PiotrRaszkowski/extended-ceiling-presence-air-sensor/v2/docs/images/v2-template.png

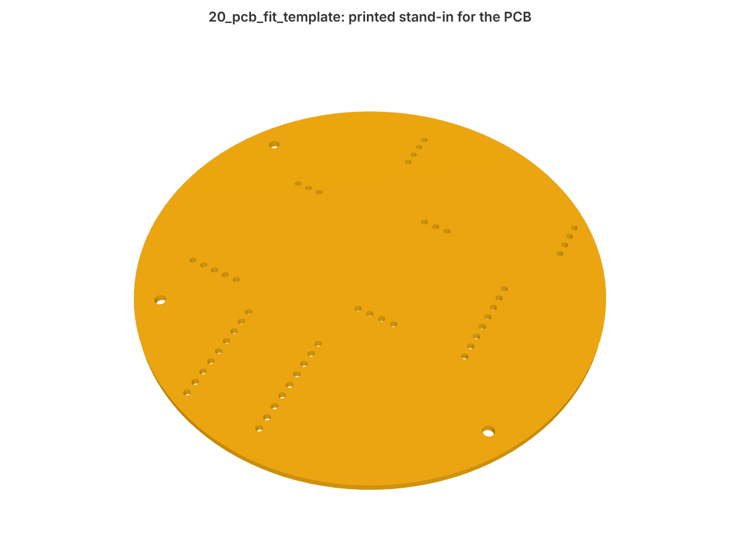
v2/docs/images/v2-template.png
