PiotrRaszkowski/extended-ceiling-presence-air-sensor/hardware/step/01_housing.step

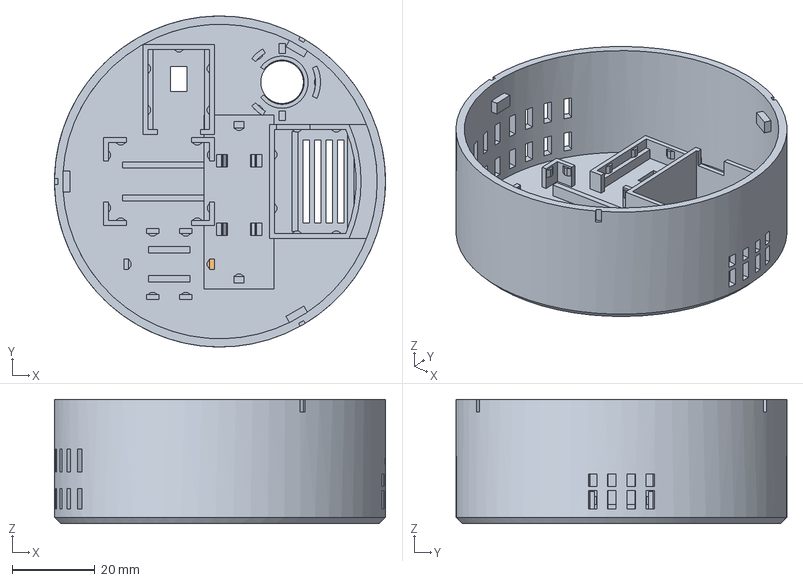
[picture p19: CAD file, 2026-10-31]
hardware/step/01_housing.step
80.0 x 80.0 x 30.0 mm
