PiotrRaszkowski/extended-ceiling-presence-air-sensor/v2/hardware/step/02_ceiling_base.step

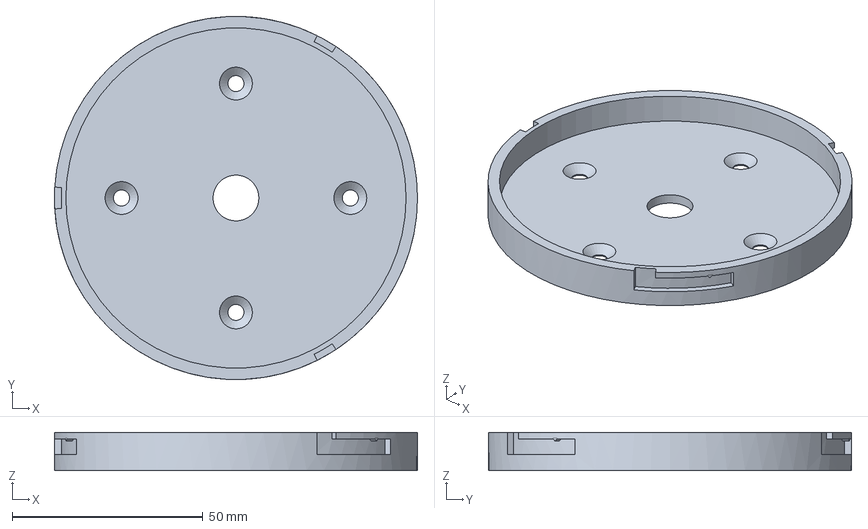
[picture p20: CAD file, 2026-10-30]
v2/hardware/step/02_ceiling_base.step
95.2 x 95.2 x 10.0 mm
