PiotrRaszkowski/extended-ceiling-presence-air-sensor/hardware/d100/step/11_seat_test_fit_d100.step

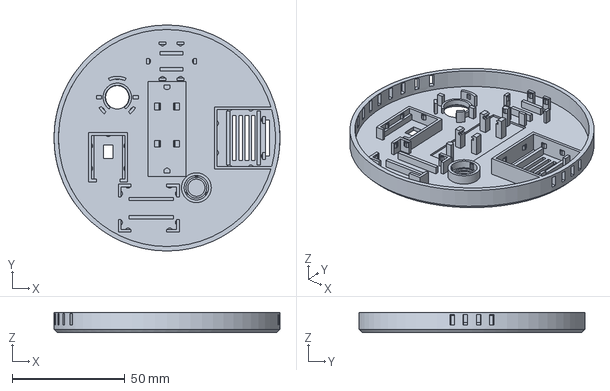
[picture p21: CAD file, 2026-11-01]
hardware/d100/step/11_seat_test_fit_d100.step
100.0 x 100.0 x 9.00 mm
