PiotrRaszkowski/extended-ceiling-presence-air-sensor/hardware/step/00_print_plate_all_parts.step

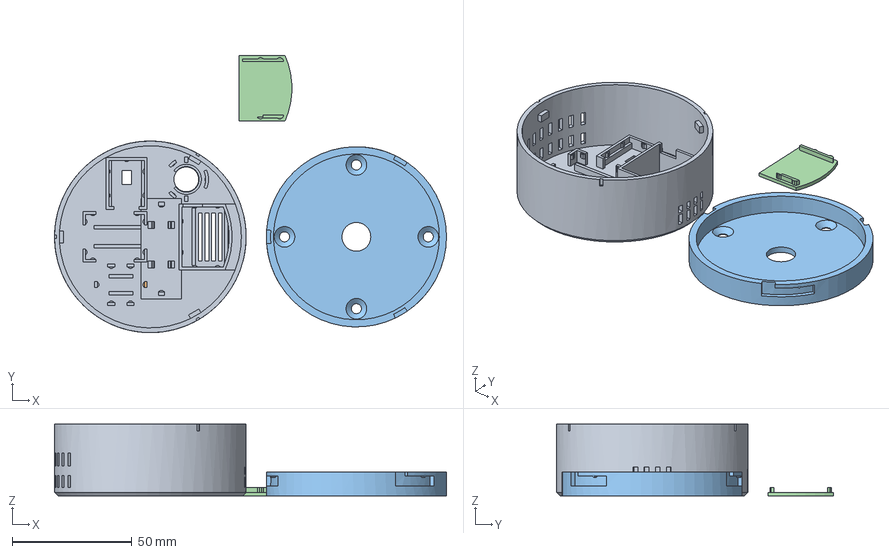
[picture p22: CAD file, 2026-10-31]
hardware/step/00_print_plate_all_parts.step
163.6 x 115.7 x 30.0 mm
