PiotrRaszkowski/extended-ceiling-presence-air-sensor/v2/hardware/step/20_pcb_fit_template.step

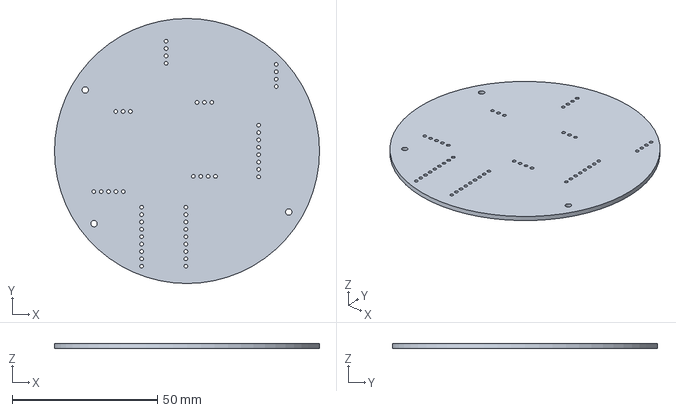
[picture p23: CAD file, 2026-10-30]
v2/hardware/step/20_pcb_fit_template.step
91.2 x 91.2 x 1.60 mm
