PiotrRaszkowski/extended-ceiling-presence-air-sensor/hardware/step/11_seat_test_fit.step

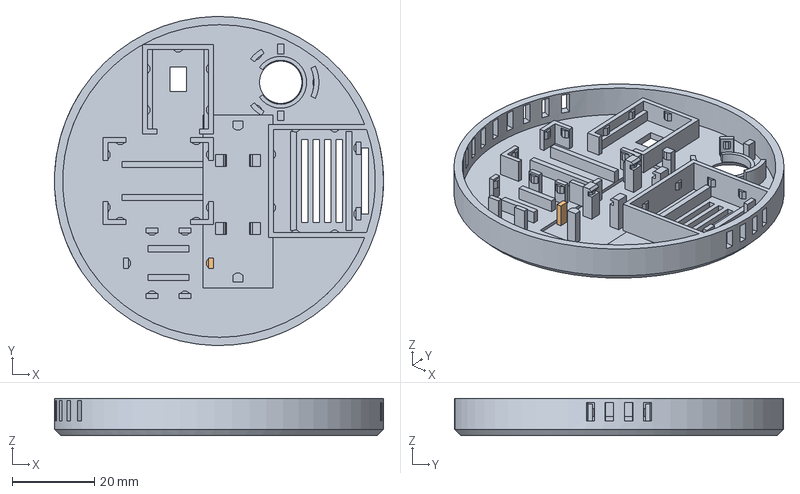
[picture p24: CAD file, 2026-10-31]
hardware/step/11_seat_test_fit.step
80.0 x 80.0 x 9.00 mm
