PiotrRaszkowski/extended-ceiling-presence-air-sensor/hardware/d100/step/00_print_plate_all_parts_d100.step

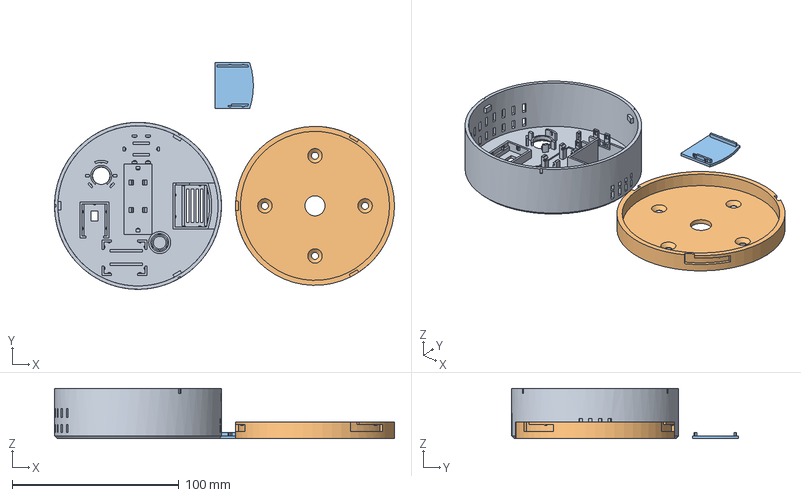
[picture p25: CAD file, 2026-11-01]
hardware/d100/step/00_print_plate_all_parts_d100.step
203.6 x 135.7 x 30.0 mm
