PiotrRaszkowski/extended-ceiling-presence-air-sensor/hardware/step/13_radar_seat_test.step

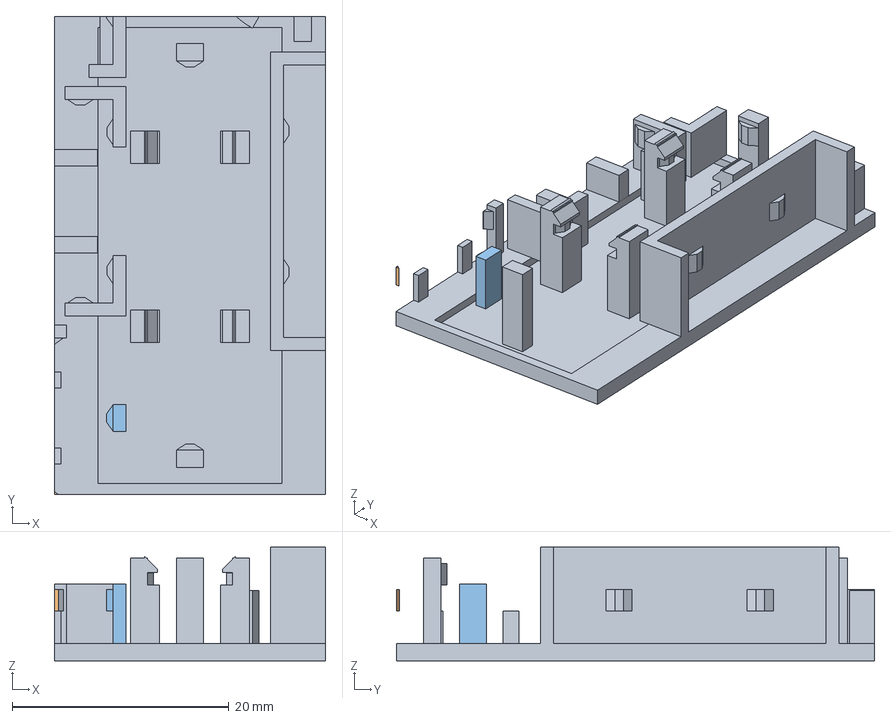
[picture p26: CAD file, 2026-10-31]
hardware/step/13_radar_seat_test.step
25.0 x 44.1 x 10.5 mm
