PiotrRaszkowski/extended-ceiling-presence-air-sensor/hardware/step/03_chamber_lid.step

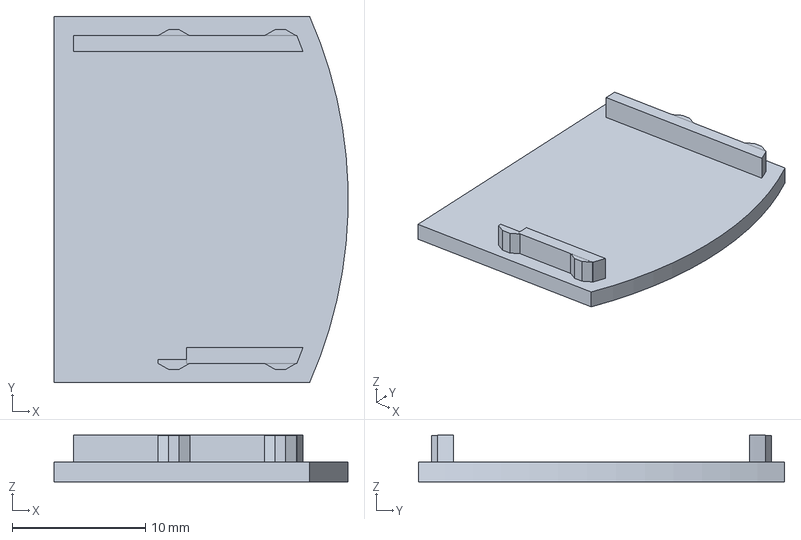
[picture p27: CAD file, 2026-10-31]
hardware/step/03_chamber_lid.step
22.1 x 27.5 x 3.50 mm
