PiotrRaszkowski/extended-ceiling-presence-air-sensor/hardware/d100/step/01_housing_d100.step

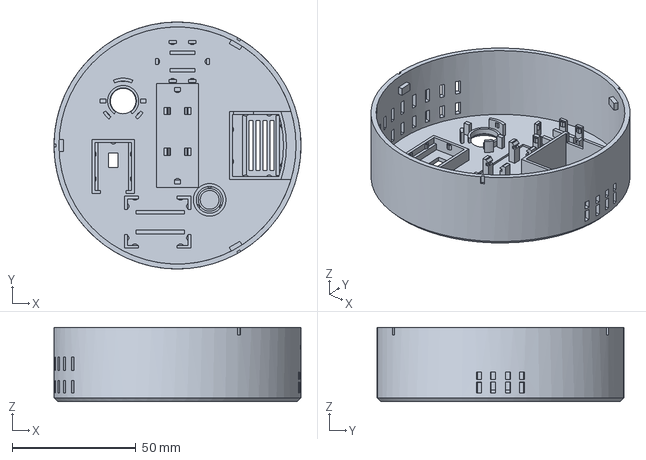
[picture p28: CAD file, 2026-11-01]
hardware/d100/step/01_housing_d100.step
100.0 x 100.0 x 30.0 mm
