PiotrRaszkowski/extended-ceiling-presence-air-sensor/hardware/step/12_radar_window_samples.step

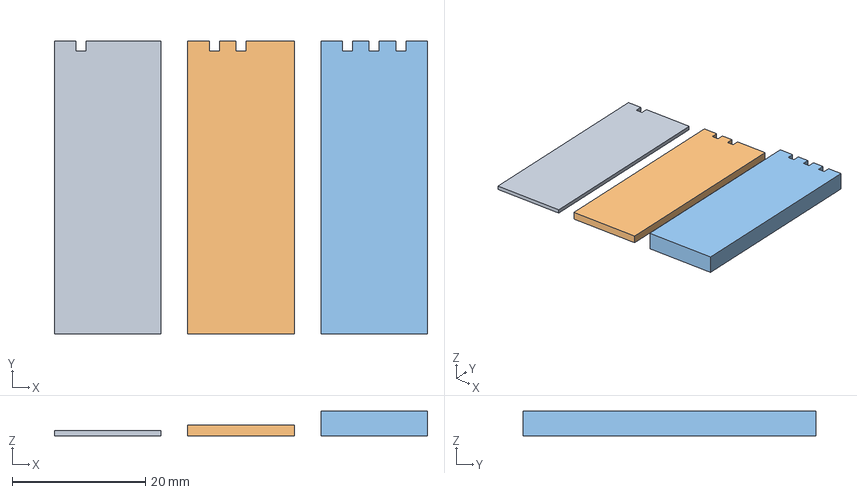
[picture p29: CAD file, 2026-10-29]
hardware/step/12_radar_window_samples.step
56.0 x 44.0 x 3.70 mm
