PiotrRaszkowski/extended-ceiling-presence-air-sensor/hardware/d100/step/13_radar_seat_test_d100.step

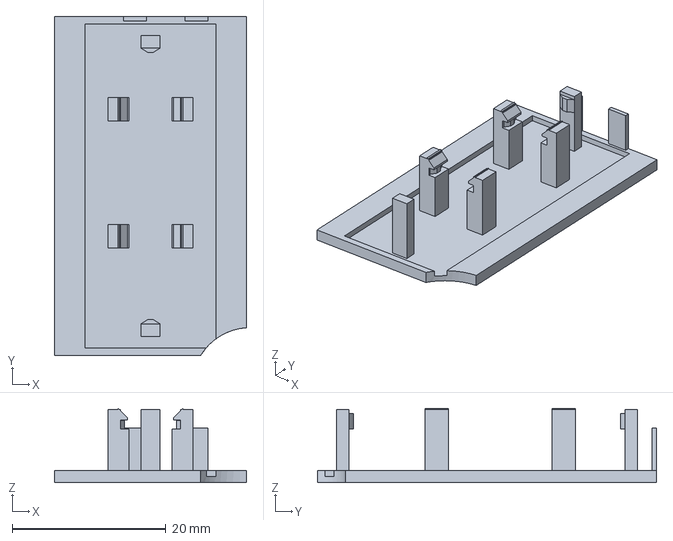
[picture p30: CAD file, 2026-10-31]
hardware/d100/step/13_radar_seat_test_d100.step
25.0 x 44.1 x 9.65 mm
