PiotrRaszkowski/extended-ceiling-presence-air-sensor/hardware/step/10_press_fit_calibration.step

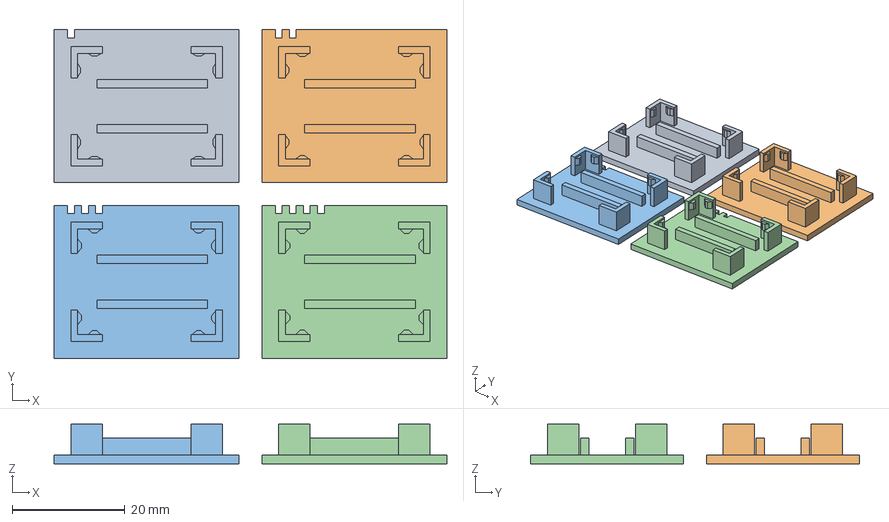
[picture p31: CAD file, 2026-10-29]
hardware/step/10_press_fit_calibration.step
69.8 x 58.4 x 7.10 mm
