PiotrRaszkowski/extended-ceiling-presence-air-sensor/hardware/d100/step/13_radar_seat_test_d100_ld2412.step

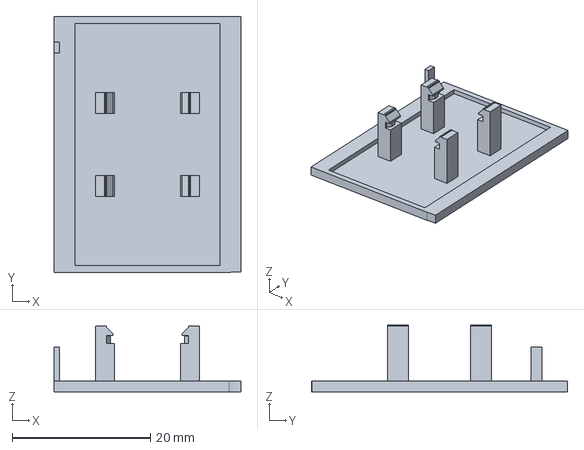
[picture p32: CAD file, 2026-10-31]
hardware/d100/step/13_radar_seat_test_d100_ld2412.step
27.0 x 37.0 x 9.65 mm
