PiotrRaszkowski/extended-ceiling-presence-air-sensor/hardware/step/02_ceiling_base.step

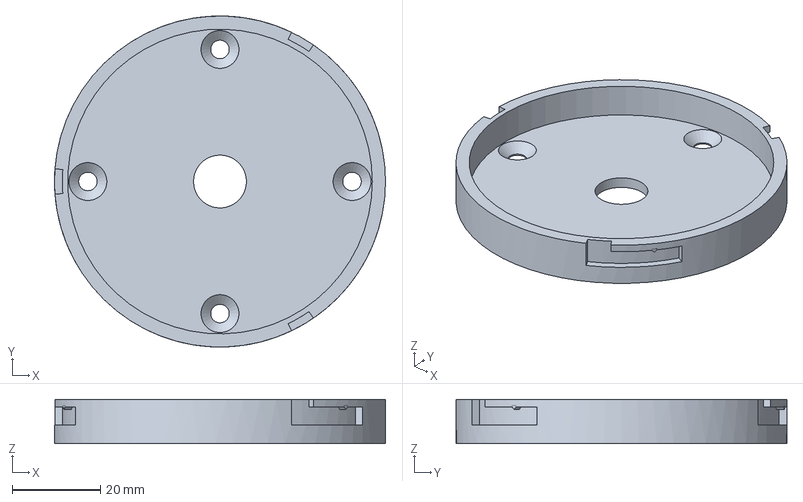
[picture p33: CAD file, 2026-10-29]
hardware/step/02_ceiling_base.step
75.2 x 75.2 x 10.0 mm
