PiotrRaszkowski/extended-ceiling-presence-air-sensor/hardware/d100/step/03_chamber_lid_d100.step

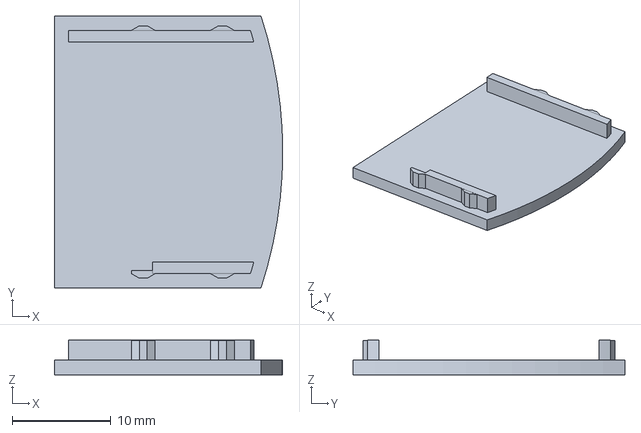
[picture p34: CAD file, 2026-10-31]
hardware/d100/step/03_chamber_lid_d100.step
23.1 x 27.5 x 3.50 mm
