PiotrRaszkowski/extended-ceiling-presence-air-sensor/(list of files, cad)

Other CAD files:
hardware/d100/step/11_seat_test_fit_d100_ld2412.step
v2/hardware/step/01_housing_v2.step
hardware/d100/step/00_print_plate_all_parts_d100_ld2412.step
hardware/d100/step/02_ceiling_base_d100.step
hardware/d100/stl/00_print_plate_all_parts_d100.stl
hardware/d100/stl/00_print_plate_all_parts_d100_ld2412.stl
hardware/d100/stl/01_housing_d100.stl
hardware/d100/stl/01_housing_d100_ld2412.stl
hardware/d100/stl/02_ceiling_base_d100.stl
hardware/d100/stl/03_chamber_lid_d100.stl
hardware/d100/stl/11_seat_test_fit_d100.stl
hardware/d100/stl/11_seat_test_fit_d100_ld2412.stl
hardware/d100/stl/13_radar_seat_test_d100.stl
hardware/d100/stl/13_radar_seat_test_d100_ld2412.stl
hardware/stl/00_print_plate_all_parts.stl
hardware/stl/01_housing.stl
hardware/stl/02_ceiling_base.stl
hardware/stl/03_chamber_lid.stl
hardware/stl/10_press_fit_calibration.stl
hardware/stl/11_seat_test_fit.stl
hardware/stl/12_radar_window_samples.stl
hardware/stl/13_radar_seat_test.stl
v2/hardware/stl/01_housing_v2.stl
v2/hardware/stl/02_ceiling_base.stl
v2/hardware/stl/20_pcb_fit_template.stl
