PiotrRaszkowski/extended-ceiling-presence-air-sensor/docs/assembly.md

# Assembly

What goes where

## 0. Bench test first

Before anything goes into the housing:

1. Flash the firmware over USB (see [firmware](firmware.md)).
2. Solder 8-10 cm wires to every module and wire everything up on the desk as in [wiring](wiring.md).
3. Power it from 12 V and check in Home Assistant that every sensor reports: occupancy, radar distances, illuminance, temperature, humidity. eCO2, TVOC and AQI stay empty for the first few minutes, and on the very first power-on for about an hour while the ENS160 runs its initial start-up.

Once the housing is closed the USB-C port is out of reach, so this is the moment to fix wiring mistakes.

## 1. Modules into their seats

A real Ø80 print (v12, before the hub seat was added) with all modules in place (ceiling side; in the first photo the ENS160 chamber is at the bottom, so the picture is turned 90° compared with the render below):

| | |
|---|---|
| All modules seated in a printed Ø80 housing, top view | The same housing from an angle |

Seen from the ceiling side (the open side of the housing), the layout is: ENS160 chamber along the right wall, the long radar board running top to bottom just left of the chamber, ESP32-S3-Zero and the S09 converter on the left next to the side vents, BH1750 top left, PIR top right. The Dupont hub stands upright against the outside of the chamber's inner wall, above the radar.

Each board sits on ledges and is gripped by small crush ribs. Push it in straight with a thumb; it should stay put without glue. If one ever works loose, a dot of hot glue on the board end fixes it.

| # | Module | How it goes in |
|---|---|---|
| 1 | LD2410B radar | Antenna side down, towards the face (the side with the gold antenna patches). Push it down between the six posts until it clicks under the four snap lips and sits on the small tabs, 6.2 mm above the thin window. To take it out, spread two posts on one side slightly. Wires leave from the back of the board at the connector end and go up, not across the antenna side. Never put glue on the antenna. |
| 2 | HC-SR602 PIR | Lens into the round hole, the two flats of the board onto the two keys, header pointing left (towards the BH1750) over the recess in the ring. |
| 3 | BH1750 (GY-302) | Components down, pins towards the open side of the seat (towards the ESP), mounting holes the other way. The chip lines up with the small window in the face. |
| 4 | ENS160+AHT21 | **Components up**, flat underside on the two ledges, pin row along the chamber's inner wall. |
| 5 | Cable pass-through | 8 × 4 mm slot at the top of the chamber side wall, in the corner next to the inner wall, for the four ENS160 wires (VIN, GND, SCL, SDA). The chamber is 23 mm tall, so a straight pin header with push-on (Dupont) jumper plugs fits standing up; soldered wires work too. |
| 6 | ESP32-S3-Zero | Bottom side down, between the four corner posts. |
| 7 | S09 converter | Bottom side down, between the posts, wires at the corners. The 220 µF capacitor goes next to it. |
| 8 | Chamber lid | Collar down, the notch in the collar over the pass-through, then press it in. To remove it, pry the edge up with a thin blade; it has no holes on purpose. |
| 9 | Dupont hub | Last, after all jumpers are plugged into the modules. Slide the perfboard down into the two channels on the chamber wall, header pins facing into the housing, solder side towards the wall, until it sits on the channel floors. Then plug in the jumpers. See [wiring](wiring.md#dupont-hub). |

After the lid is on, seal the pass-through around the wires with a bit of plasticine or putty so warm air from the electronics doesn't leak into the chamber.

### Why the ENS160 board faces up

The ENS160 and AHT21 sample air by diffusion, so they don't need to "look" at the grille. What matters is that the air in the chamber gets replaced and that heat from the ESP and the S09 stays out. The grille in the face is the inlet and the upper row of slots in the housing wall, a few millimetres above the board, is the outlet. The ENS160 heater and the temperature difference drive a slow flow from bottom to top around the board.

Mounted components-up, the board lies on its flat underside and the milled slot around the AHT21 (which isolates it from the ENS160 heater) doesn't touch any ledge.

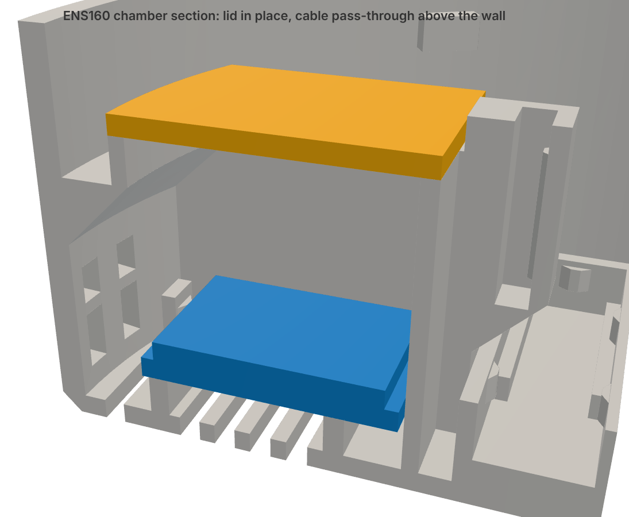
[picture p37: docs/images/chamber-section.png]
ENS160 chamber, section


Close-ups of the seats:

| Radar | PIR | ESP32-S3-Zero | ENS160 chamber |
|---|---|---|---|
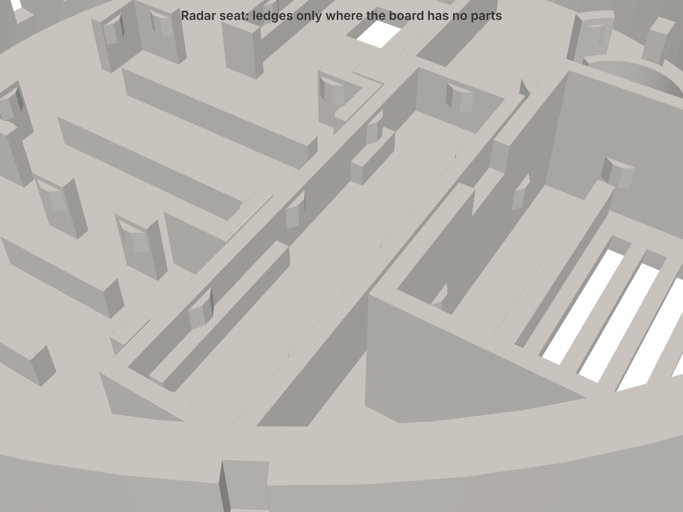
[picture p38: docs/images/seat-radar.png]
Radar seat
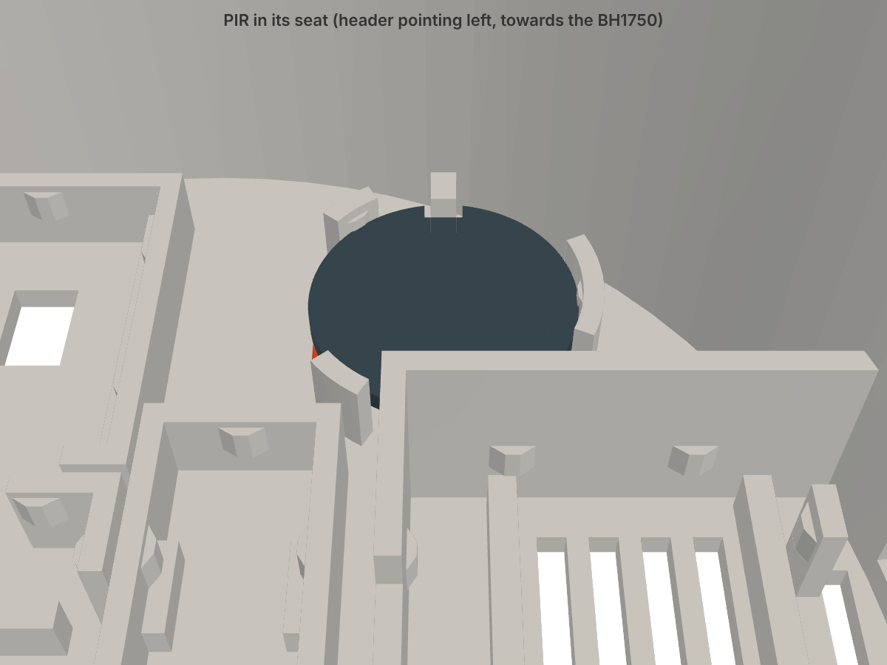
[picture p39: docs/images/seat-pir.png]
PIR seat
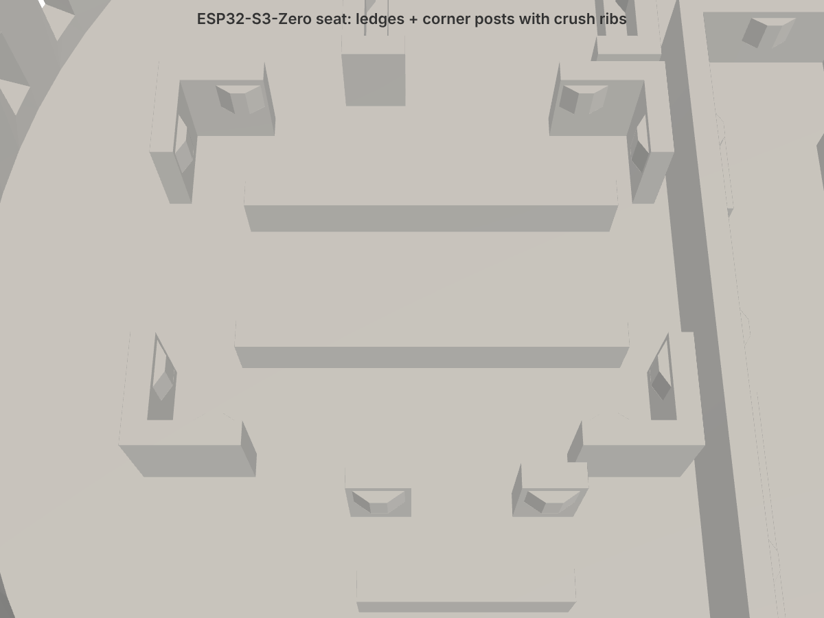
[picture p40: docs/images/seat-esp32.png]
ESP seat
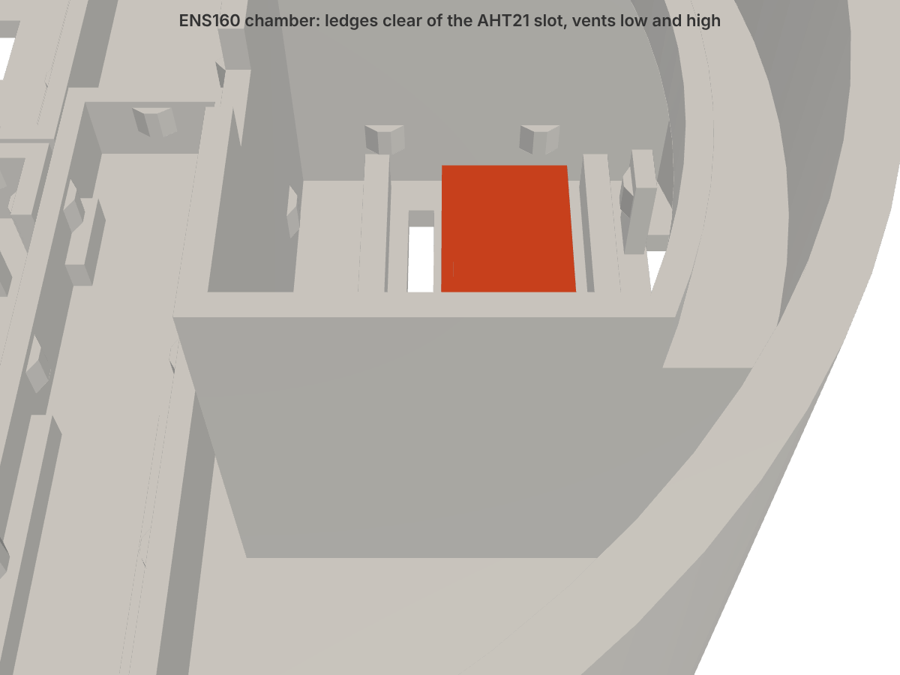
[picture p41: docs/images/chamber-ens160.png]
ENS160 chamber
|  |  |  |  |

## 2. Wires

With Dupont jumpers, every module gets one jumper per net to the hub, plus one jumper from the ESP 3V3 pin straight to BH1750 VCC and the signal jumpers (GP4/GP5 to the radar, GP6 to the PIR) straight from the ESP. The ENS160 jumpers leave the chamber through the pass-through and go over the channel to the front of the hub.

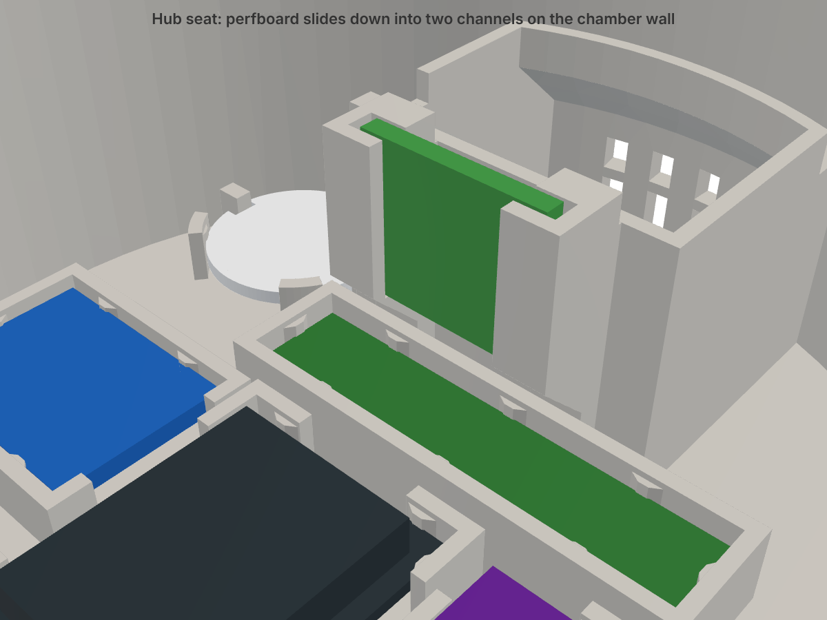
[picture p42: docs/images/hub-seat.png]
Hub seat


Otherwise route the wires flat along the face. Keep the top 10 mm along the outer wall free: that's where the ring of the ceiling base slides in. Gather the cables towards the centre, where the 12 V cable comes through the base.

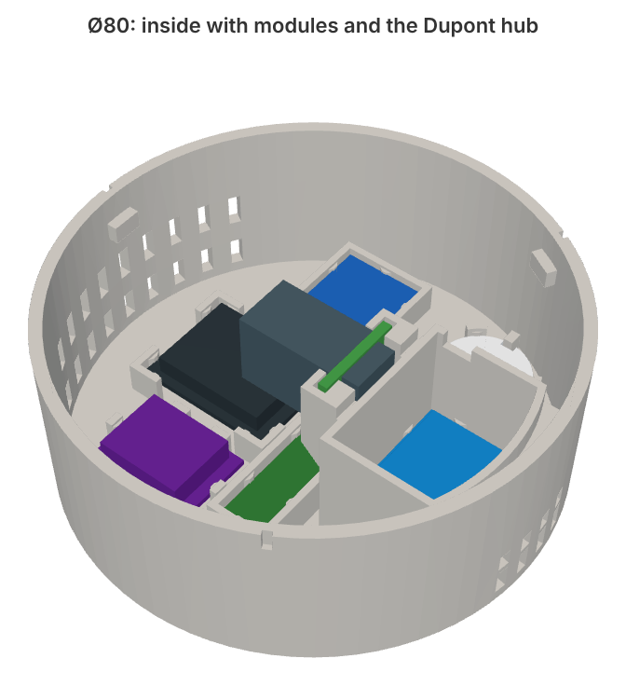
[picture p43: docs/images/inside-with-modules.png]
Inside with modules


## 3. Ceiling mount

1. Screw the base to the ceiling, or onto a Ø60 flush box (60 mm hole spacing). Use countersunk screws with heads no wider than 8.6 mm: the heads clear the bayonet ring by only 0.3 mm. Feed the 12 V cable through the centre hole.
2. Optional: stick a ~1 mm foam strip on the housing rim so it sits flush against an uneven ceiling.
3. Connect 12 V through the Wago/JST connector and tie the cable for strain relief.
4. Line up the marks on the housing edge with the groove entries in the base ring.
5. Push the housing up against the ceiling and turn it about 25° **counter-clockwise, looking up at it from below**.
6. Let go. The housing drops 0.8 mm and the detent stops it from turning back. To take it off: push up, turn clockwise, pull down.

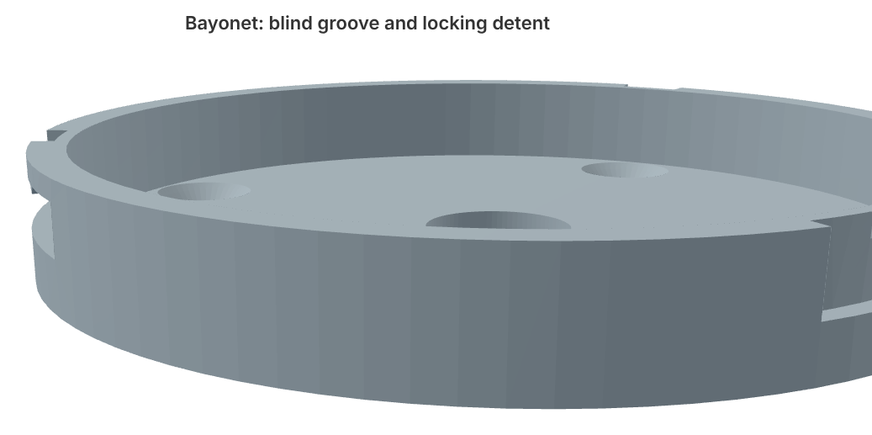
[picture p44: docs/images/bayonet.png]
Bayonet


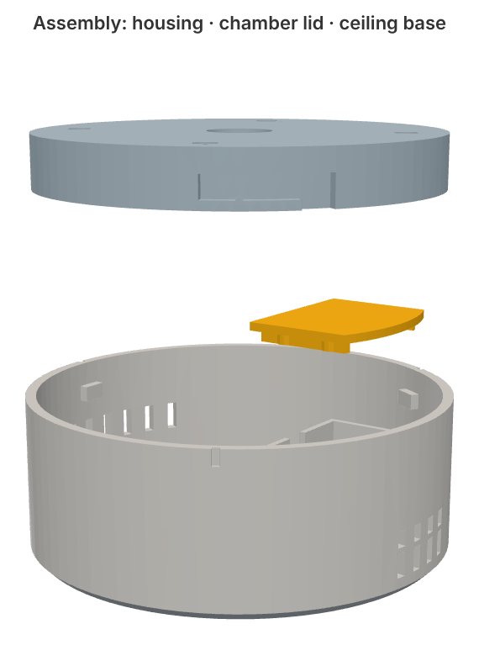
[picture p45: docs/images/assembly-exploded.png]
Exploded view


## Where to mount it

- In the middle of the room, away from ventilation outlets, the kitchen hob and direct sunlight on the face.
- The radar looks straight down. At a normal 2.5-2.7 m ceiling the floor is in gate 3 (one gate is 0.75 m). The radar also sees through thin walls, so limit its range in [tuning](tuning.md).
- The HC-SR602 has a ~100° cone. From 2.6 m that covers a circle about 3 m in radius.
- Air under the ceiling is often warmer than at head height. Calibrate the temperature offset after a day, see [tuning](tuning.md).

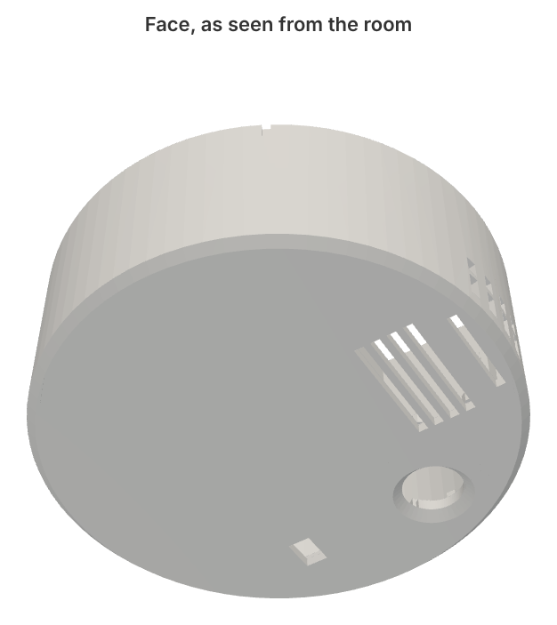
[picture p46: docs/images/face.png]
Face, seen from the room
