PiotrRaszkowski/extended-ceiling-presence-air-sensor/docs/images/d100-assembly-exploded.png

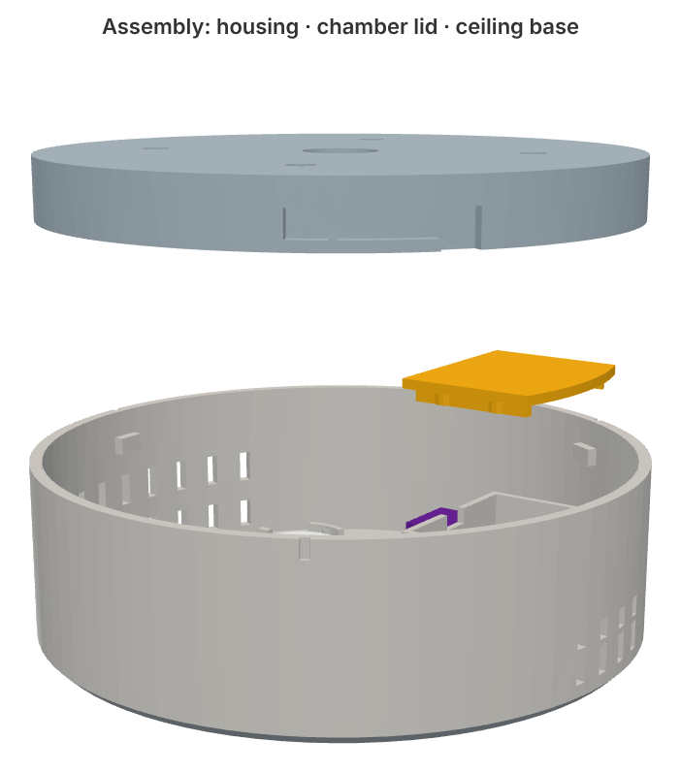
docs/images/d100-assembly-exploded.png
