PiotrRaszkowski/extended-ceiling-presence-air-sensor/v2/hardware/pcb/carrier.kicad_pcb

## KiCad design v2/hardware/pcb/carrier.kicad_pcb (2026-10-30)

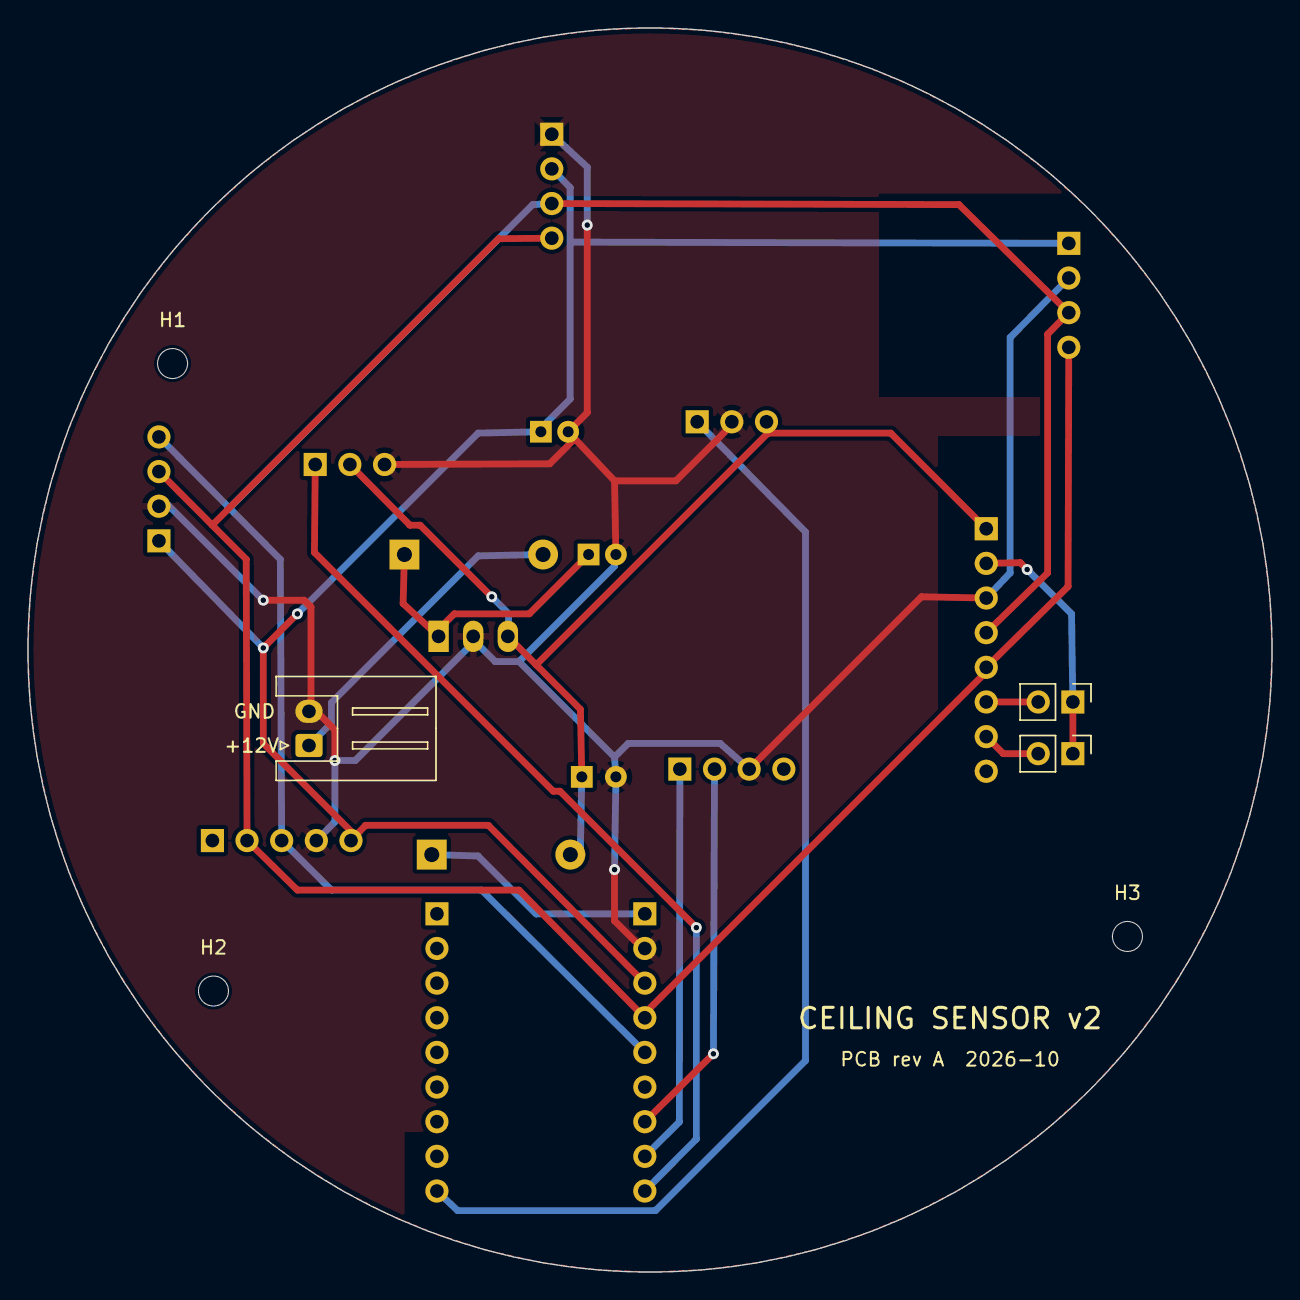
[picture p53: board carrier.kicad_pcb from above]

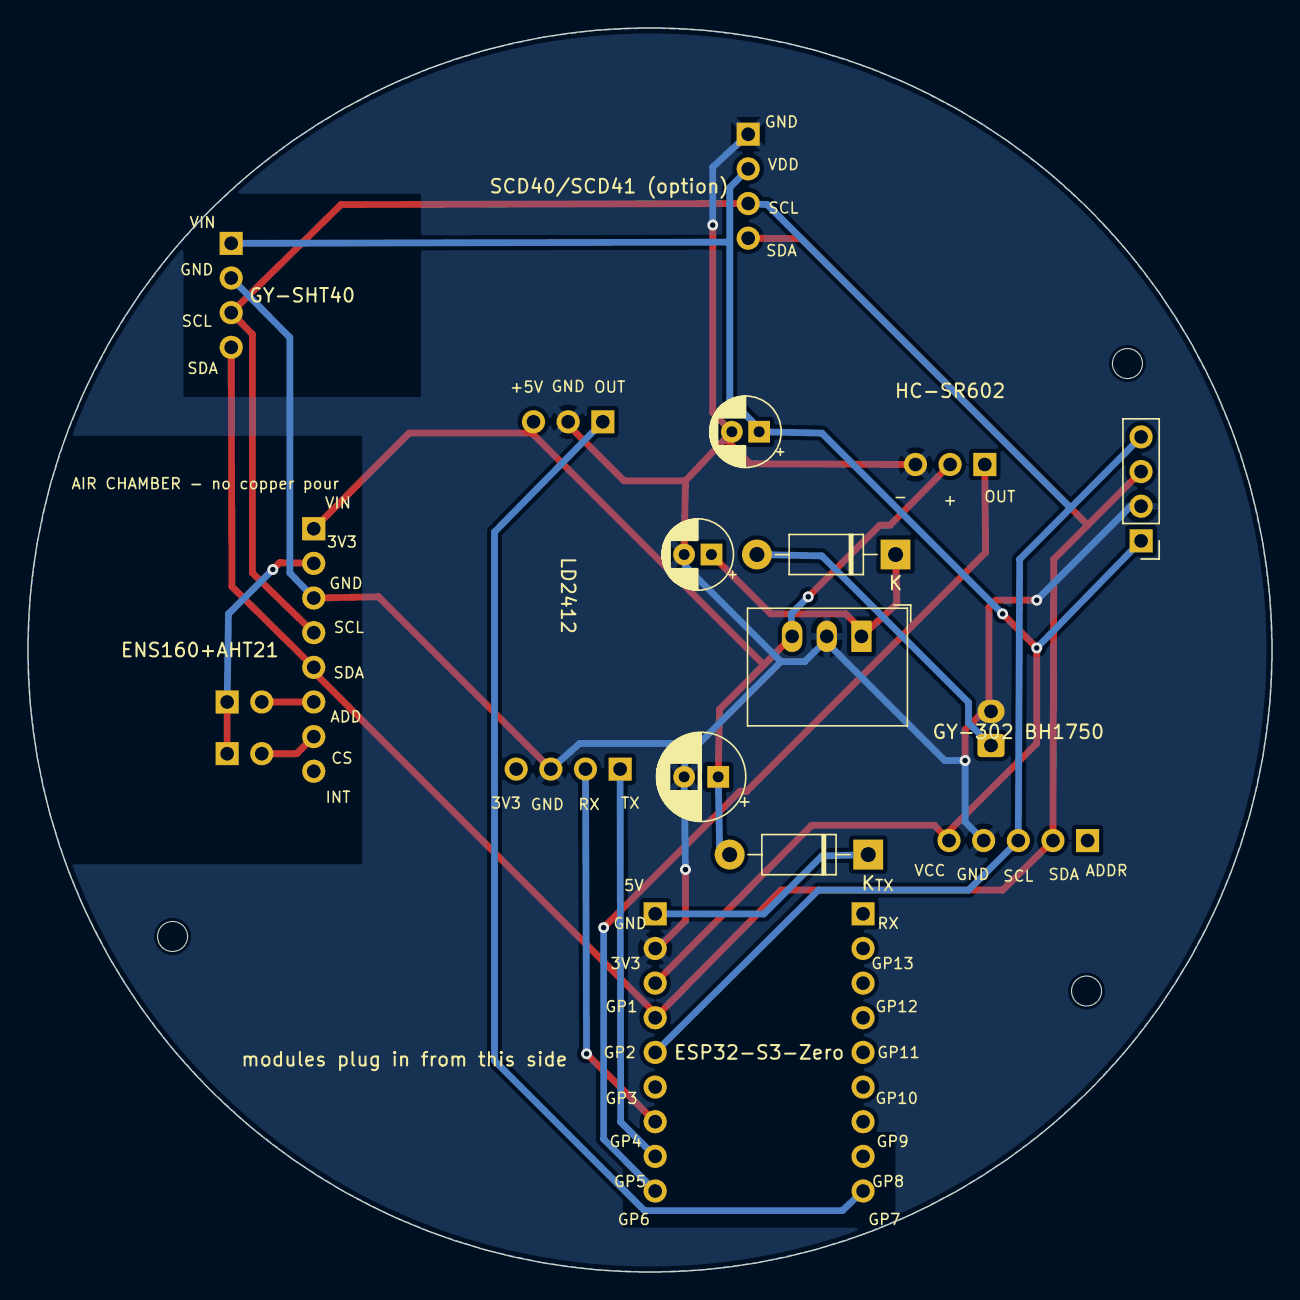
[picture p54: board carrier.kicad_pcb from below]

Board: 2 copper layers, 91.2 x 91.2 mm, 22 parts (16 on the bottom side), 15 nets.

Parts:
C1: 10uF 25V; CP_Radial_D5.0mm_P2.00mm
C2: 220uF 10V; CP_Radial_D6.3mm_P2.50mm
C3: 47uF 10V (with SCD4x); CP_Radial_D5.0mm_P2.00mm
CH1: ENS160 chamber walls (housing); ChamberWalls
CH2: SHT40 pocket walls (housing); PocketWalls
D1, D2: 1N5819; D_DO-41_SOD81_P10.16mm_Horizontal
H1, H2, H3: M2 to housing boss; MountingHole_2.2mm_M2
J1: 12V IN (JST-XH); JST_XH_S2B-XH-A_1x02_P2.50mm_Horizontal
J2: I2C expansion (not fitted); PinHeader_1x04_P2.54mm_Vertical
JP1: ADD strap; PinHeader_1x02_P2.54mm_Vertical
JP2: CS strap; PinHeader_1x02_P2.54mm_Vertical
U1: K7805-1000R3 / R-78E5.0-1.0; Converter_DCDC_RECOM_R-78E-0.5_THT
U2: ESP32-S3-Zero; Module_ESP
U3: LD2412; Module_RADAR
U4: HC-SR602; Module_PIR
U5: GY-302 BH1750; Module_BH
U6: ENS160+AHT21; Module_ENS
U7: SCD40/SCD41 (option); Module_SCD
U8: GY-SHT40; Module_SHT

Connections:
+3V3: C3.1, J2.1, U2.12 (3V3), U5.5 (VCC), U7.2 (VDD), U8.1 (VIN)
+5V: C2.1, D2.2, U1.3, U3.7 (+5V), U4.2 (+), U6.1 (VIN)
ENS_3V3: JP1.1, JP2.1, U6.2 (3V3)
ENS_ADD: JP1.2, U6.6 (ADD)
ENS_CS: JP2.2, U6.7 (CS)
ESP_5V: D2.1, U2.10 (5V)
GND: C1.2, C2.2, C3.2, J1.2, J2.2, U1.2, U2.11 (GND), U3.3 (GND), U3.6 (GND), U4.3 (-), U5.4 (GND), U6.3 (GND), U7.1 (GND), U8.2 (GND)
PIR_OUT: U2.18 (GP6), U4.1 (OUT)
RADAR_OUT: U2.9 (GP7), U3.5 (OUT)
RADAR_RX: U2.16 (GP4), U3.2 (RX)
RADAR_TX: U2.17 (GP5), U3.1 (TX)
SCL: J2.4, U2.14 (GP2), U5.3 (SCL), U6.4 (SCL), U7.3 (SCL), U8.3 (SCL)
SDA: J2.3, U2.13 (GP1), U5.2 (SDA), U6.5 (SDA), U7.4 (SDA), U8.4 (SDA)
VIN: C1.1, D1.1, U1.1
VIN_RAW: D1.2, J1.1
