PiotrRaszkowski/extended-ceiling-presence-air-sensor/(commit log)

2026-10-29 Initial release: ceiling presence + air quality sensor
    ESPHome firmware, Ø80 PETG enclosure (STL/STEP + CadQuery source),
    wiring diagram, BOM with Allegro and AliExpress links, printing,
    assembly, Home Assistant and tuning docs.
    Claude-Session: https://claude.ai/code/session_012hTjUXJJHKxpQwcsCnExu2
    [00_print_plate_all_parts.step, 00_print_plate_all_parts.stl, 00_print_plate_all_parts_d100.stl, 01_housing.step, 01_housing.stl, 01_housing_d100.stl, 02_ceiling_base.step, 02_ceiling_base.stl]
2026-10-29 Taller ENS160 chamber (v12) for pin headers with jumper plugs
    The chamber is 23 mm tall instead of 13 mm. Above 19.5 mm its outer
    wall steps in at 45 degrees to clear the ceiling base ring. The lid
    follows the new outline, and its crush ribs moved inwards. No other
    seats changed. Base ring and lid interference checks are unchanged
    from v11.
    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
    [00_print_plate_all_parts.step, 00_print_plate_all_parts.stl, 01_housing.step, 01_housing.stl, 02_ceiling_base.step, 03_chamber_lid.step, 03_chamber_lid.stl, 10_press_fit_calibration.step]
2026-10-29 Ø100 version from the same source, with the taller chamber
    enclosure.py takes the size as an argument (80 by default, or 100) and
    switches the module layout. The Ø80 output is byte-for-byte the same as
    before. The Ø100 seats match v10. The generated Ø100 files replace
    hardware/legacy-d100 and now live in hardware/d100 as STL and STEP.
    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
    [00_print_plate_all_parts_d100.step, 00_print_plate_all_parts_d100.stl, 01_housing_d100.step, 01_housing_d100.stl, 02_ceiling_base_d100.step, 02_ceiling_base_d100.stl, 03_chamber_lid_d100.step, 03_chamber_lid_d100.stl]
2026-10-29 Ø80: tighter BH1750 seat (+0.05 mm interference)
    The printed Ø80 seat came out loose, while the same seat in Ø100 fits.
    Ø100 output is unchanged.
    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
    [00_print_plate_all_parts.step, 00_print_plate_all_parts.stl, 01_housing.step, 01_housing.stl, 11_seat_test_fit.step, 11_seat_test_fit.stl]
2026-10-29 Simpler wiring: no diode, no PIR RC filter
    The only extra part left is the 220 µF on the S09 output. The diode and
    the RC filter are now listed as optional parts. The new rule is to
    never connect USB and 12 V at the same time. A stripboard junction
    replaces the in-line splices. Diagram, wiring, BOM, tuning and firmware
    docs are updated to match.
    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
    [ceiling-sensor.yaml, wiring_diagram.py]
2026-10-29 OpenSCAD port of the enclosure with Customizer tabs per module
    hardware/source/enclosure.scad covers both sizes and all parts. Board
    sizes, extra interference and seat positions can be changed per module.
    With default values it matches the CadQuery output up to curve faceting
    (<0.7 % volume at resolution 128, bounding boxes within 0.0001 mm).
    It works in OpenSCAD 2021.01 and newer.
    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
    [enclosure.scad]
2026-10-29 ESP32-S3-Zero pinout image (top and bottom view, used pins highlighted)
    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
2026-10-29 Add photos of a printed Ø80 housing with all modules seated
    The photos are resized and their EXIF data removed. README status for
    Ø80 now reflects the real print: v12 fitted, and the BH1750 seat was
    tightened in v13.
    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
2026-10-29 v14: Dupont hub seat on the chamber wall (Ø80 and Ø100)
    A 6 x 5-hole perfboard with male headers stands upright in two channels
    on the outside of the ENS160 chamber inner wall. The channels grip the
    empty outer columns, and a crush rib on each slot holds the board. In
    Ø80 the channels clear the radar seat with a 45 degree overhang, and the
    board height is set automatically.
    The ENS160 pass-through moved to the chamber side wall next to the
    inner wall. The lid notch and lid ribs follow it.
    Collision checks: the hub and its plugs clear every module dummy, the
    ESP Dupont plugs, the lid and the base at all bayonet angles.
    Docs: hub layout diagram, wiring/BOM/assembly updates, new renders.
    Co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
    [00_print_plate_all_parts.step, 00_print_plate_all_parts.stl, 00_print_plate_all_parts_d100.step, 00_print_plate_all_parts_d100.stl, 01_housing.step, 01_housing.stl, 01_housing_d100.step, 01_housing_d100.stl]
2026-10-29 OpenSCAD port updated to v14 (Dupont hub tab, pass-through side)
    It matches the v14 CadQuery output up to curve faceting for both sizes.
    With hub_enabled=false the only difference is the two channels.
    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
    [enclosure.scad]
2026-10-30 v2: carrier PCB, LD2412 radar, optional SCD4x (designed, not built)
    - layout.py holds module positions, pin orders and nets; the KiCad board,
    housing, schematic and assembly drawings are generated from it
    - 2-layer round PCB (91.2 mm), routed by router.py, DRC clean, Gerbers for JLCPCB
    - Ø100 housing with screw bosses, closed ENS160 chamber, radar window with
    pin pockets; collision check against modules, sockets, parts and the base
    - ESPHome config for the LD2412 and an optional scd4x package
    - docs: BOM, pre-order checks, PCB ordering/soldering, assembly, firmware
    Claude-Session: https://claude.ai/code/session_012hTjUXJJHKxpQwcsC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
    [01_housing_v2.step, 01_housing_v2.stl, 02_ceiling_base.step, 02_ceiling_base.stl, 20_pcb_fit_template.step, 20_pcb_fit_template.stl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]
2026-10-30 v2 docs: board size after the outline change
    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
2026-10-30 v2: PIR socket pin order OUT, +, - (+ in the middle, as on the HW-438 board)
    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
    [01_housing_v2.step, 02_ceiling_base.step, 20_pcb_fit_template.step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]
2026-10-30 v2: separate SHT40 for room temperature/humidity in its own pocket
    The AHT21 on the ENS160 combo board reads ~10 degC high on the prototype
    (the ENS160 heater sits next to it). v2 adds a GY-SHT40 (U8) in a walled,
    vented pocket with no copper pour above it; the AHT21 now only feeds the
    ENS160 compensation and shows up as a diagnostic chamber temperature.
    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
    [01_housing_v2.step, 01_housing_v2.stl, 02_ceiling_base.step, 20_pcb_fit_template.step, 20_pcb_fit_template.stl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]
2026-10-30 Enclosure v15: 0.8 mm radar window, radar seat test print
    The 3.7 mm window with the board 2 mm above it made the LD2410B report
    40-60 move energy on every gate in an empty room (1-9 with the radar
    out of the housing, same supply and spot). Hi-Link's half-wave window
    also needs a 6.2/12.4/18.6 mm gap; the alternative is a window of 1/8
    wavelength or thinner, which is what this uses. Adds
    13_radar_seat_test to check a filament before printing the housing.
    OpenSCAD port updated to match.
    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
    [00_print_plate_all_parts.step, 00_print_plate_all_parts.stl, 00_print_plate_all_parts_d100.step, 00_print_plate_all_parts_d100.stl, 01_housing.step, 01_housing.stl, 01_housing_d100.step, 01_housing_d100.stl]
2026-10-30 Enclosure v16: radar on posts 6.2 mm above the window, wider ENS160 pass-through, ribs 0.13 mm
    The radar no longer sits in a walled pocket. Like the S09 it stands
    on posts (two per long side, one per end) with small tabs under the
    board edge only at the long-side posts, 6.2 mm (half a wavelength in
    air) above the 0.8 mm window. ENS160 cable pass-through is now 8 x 4 mm
    for four jumper wires. RIB_INTERF 0.13 mm: 0.1 held every board on the
    Ø100 print, but a touch loosely. OpenSCAD port updated to match.
    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
    [00_print_plate_all_parts.step, 00_print_plate_all_parts.stl, 00_print_plate_all_parts_d100.step, 00_print_plate_all_parts_d100.stl, 01_housing.step, 01_housing.stl, 01_housing_d100.step, 01_housing_d100.stl]
2026-10-31 Enclosure v17: snap lips hold the radar on its posts
    The radar fell out of the v16 seat test print. The four long-side posts
    now have lips that close 0.5 mm over the board edge, 0.15 mm above a
    1.0 mm board, with a 45 degree lead-in so the board clicks in. Radar
    crush ribs get +0.05 mm. OpenSCAD port updated to match.
    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
    [00_print_plate_all_parts.step, 00_print_plate_all_parts.stl, 00_print_plate_all_parts_d100.step, 00_print_plate_all_parts_d100.stl, 01_housing.step, 01_housing.stl, 01_housing_d100.step, 01_housing_d100.stl]
2026-10-31 Enclosure v18: radar posts off the chip, ribs a hair looser, hub 0.8 mm higher
    In the v17 seat test print the snap lips 6.5 mm from the end without the
    connector landed on a chip on the back of the board. That pair moves to
    11 mm. The radar ribs drop from +0.05 to +0.02 mm (a hair tight with the
    lips). The moved posts reach under the Dupont plugs, so the hub's lowest
    position goes from 9.2 to 10.0 mm. OpenSCAD port updated to match.
    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
    [00_print_plate_all_parts.step, 00_print_plate_all_parts.stl, 00_print_plate_all_parts_d100.step, 00_print_plate_all_parts_d100.stl, 01_housing.step, 01_housing.stl, 01_housing_d100.step, 01_housing_d100.stl]
2026-10-31 Optional LD2412 seat in the v1 Ø100 housing, firmware variant
    enclosure.py takes an 'ld2412' argument: the radar seat becomes 11 x 28 mm
    (datasheet, to be checked) on four posts with snap lips and no end posts,
    because the LD2412 has pin columns at both ends. Files get an _ld2412
    suffix. firmware/ceiling-sensor-ld2412.yaml is the v1 config with the
    radar swapped for the LD2412 (validated with ESPHome 2026.10).
    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
    [00_print_plate_all_parts_d100_ld2412.step, 00_print_plate_all_parts_d100_ld2412.stl, 01_housing_d100_ld2412.step, 01_housing_d100_ld2412.stl, 11_seat_test_fit_d100_ld2412.step, 11_seat_test_fit_d100_ld2412.stl, 13_radar_seat_test_d100_ld2412.step, 13_radar_seat_test_d100_ld2412.stl]
2026-10-31 Enclosure v20: chamber lid ribs +0.08 mm
    The lid sat a little loose with RIB_INTERF alone. OpenSCAD port updated.
    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
    [00_print_plate_all_parts.step, 00_print_plate_all_parts.stl, 00_print_plate_all_parts_d100.step, 00_print_plate_all_parts_d100.stl, 00_print_plate_all_parts_d100_ld2412.step, 00_print_plate_all_parts_d100_ld2412.stl, 03_chamber_lid.step, 03_chamber_lid.stl]
2026-10-31 LD2412 firmware: threshold numbers for all 14 gates
    Changing one gate threshold in ESPHome 2026.10 writes all 14 gates from
    a fixed-size array of number pointers; gates 9-13 had none, so the ESP
    crashed and rebooted on every threshold change. Listing all gates fixes it.
    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
    [ceiling-sensor-ld2412.yaml]
2026-10-31 v1: external air-quality LED, no Dupont hub channels
    Housing v21: the Dupont hub lies loose in practice, so its channels are
    off by default (HUB_SEAT). The Ø100 face gets a seat and a 0.6 mm spot for
    a WS2812B on a round ~10 mm board. Firmware: the LED on GPIO8 shows the
    ENS160 AQI colour, with an 'Air quality indicator' mode (always, when
    occupied, only when air is poor, off) and a brightness number. Compiled
    with ESPHome 2026.10.1. OpenSCAD port updated to match.
    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
    [00_print_plate_all_parts.step, 00_print_plate_all_parts.stl, 00_print_plate_all_parts_d100.step, 00_print_plate_all_parts_d100.stl, 00_print_plate_all_parts_d100_ld2412.step, 00_print_plate_all_parts_d100_ld2412.stl, 01_housing.step, 01_housing.stl]
2026-11-01 AQ LED seat: rest the board on its outer edge only
    The common 10 mm WS2812B modules have a resistor and a capacitor on the
    LED side right next to the LED; the ledge now starts at r = 4.6 mm so
    they stay free.
    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
    [00_print_plate_all_parts_d100.step, 00_print_plate_all_parts_d100.stl, 00_print_plate_all_parts_d100_ld2412.step, 00_print_plate_all_parts_d100_ld2412.stl, 01_housing_d100.step, 01_housing_d100.stl, 01_housing_d100_ld2412.step, 01_housing_d100_ld2412.stl]
